qqqqLH/STM32_smart_door/BSP/BEEP/蜂鸣器.jpg

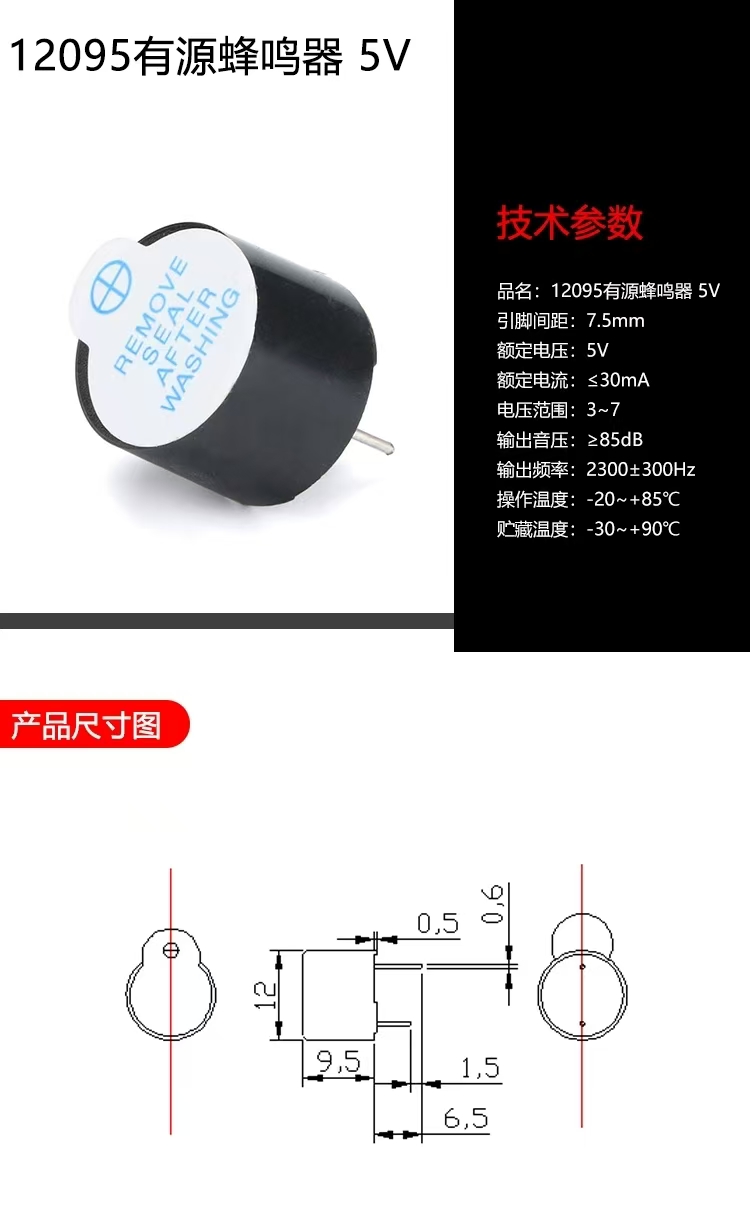
BSP/BEEP/蜂鸣器.jpg
