qqqqLH/STM32_smart_door/(list of files, cad)

Other CAD files:
BSP/SERVO/舵机控制例程/舵机控制例程/舵机例程/180度舵机 51单片机例程/STARTUP.OBJ
BSP/SERVO/舵机控制例程/舵机控制例程/舵机例程/360度舵机 51单片机例程/STARTUP.OBJ
BSP/SERVO/舵机控制例程/舵机控制例程/舵机例程/180度舵机 51单片机例程/180度舵机.OBJ
BSP/SERVO/舵机控制例程/舵机控制例程/舵机例程/360度舵机 51单片机例程/360度舵机.OBJ
