qqqqLH/STM32_smart_door/BSP/SERVO/舵机控制例程/舵机控制例程/舵机例程/180度舵机 STM32   例程/STM32_Server_180Test/OBJ/STM32_Server_Test.htm

# Static Call Graph for image ..\OBJ\STM32_Server_Test.axf

#<CALLGRAPH># ARM Linker, 5050106: Last Updated: Thu Oct 27 08:49:28 2022

### Maximum Stack Usage = 64 bytes + Unknown(Functions without stacksize, Cycles, Untraceable Function Pointers)

### Call chain for Maximum Stack Depth:

__rt_entry_main ⇒ main ⇒ TIM8_PWM_Init ⇒ GPIO_Init

### Functions with no stack information

- __user_initial_stackheap

### Mutually Recursive functions

- ADC1_2_IRQHandler ⇒ ADC1_2_IRQHandler

### Function Pointers

- ADC1_2_IRQHandler from startup_stm32f10x_hd.o(.text) referenced from startup_stm32f10x_hd.o(RESET)
- ADC3_IRQHandler from startup_stm32f10x_hd.o(.text) referenced from startup_stm32f10x_hd.o(RESET)
- BusFault_Handler from stm32f10x_it.o(.text) referenced from startup_stm32f10x_hd.o(RESET)
- CAN1_RX1_IRQHandler from startup_stm32f10x_hd.o(.text) referenced from startup_stm32f10x_hd.o(RESET)
- CAN1_SCE_IRQHandler from startup_stm32f10x_hd.o(.text) referenced from startup_stm32f10x_hd.o(RESET)
- DMA1_Channel1_IRQHandler from startup_stm32f10x_hd.o(.text) referenced from startup_stm32f10x_hd.o(RESET)
- DMA1_Channel2_IRQHandler from startup_stm32f10x_hd.o(.text) referenced from startup_stm32f10x_hd.o(RESET)
- DMA1_Channel3_IRQHandler from startup_stm32f10x_hd.o(.text) referenced from startup_stm32f10x_hd.o(RESET)
- DMA1_Channel4_IRQHandler from startup_stm32f10x_hd.o(.text) referenced from startup_stm32f10x_hd.o(RESET)
- DMA1_Channel5_IRQHandler from startup_stm32f10x_hd.o(.text) referenced from startup_stm32f10x_hd.o(RESET)
- DMA1_Channel6_IRQHandler from startup_stm32f10x_hd.o(.text) referenced from startup_stm32f10x_hd.o(RESET)
- DMA1_Channel7_IRQHandler from startup_stm32f10x_hd.o(.text) referenced from startup_stm32f10x_hd.o(RESET)
- DMA2_Channel1_IRQHandler from startup_stm32f10x_hd.o(.text) referenced from startup_stm32f10x_hd.o(RESET)
- DMA2_Channel2_IRQHandler from startup_stm32f10x_hd.o(.text) referenced from startup_stm32f10x_hd.o(RESET)
- DMA2_Channel3_IRQHandler from startup_stm32f10x_hd.o(.text) referenced from startup_stm32f10x_hd.o(RESET)
- DMA2_Channel4_5_IRQHandler from startup_stm32f10x_hd.o(.text) referenced from startup_stm32f10x_hd.o(RESET)
- DebugMon_Handler from stm32f10x_it.o(.text) referenced from startup_stm32f10x_hd.o(RESET)
- EXTI0_IRQHandler from startup_stm32f10x_hd.o(.text) referenced from startup_stm32f10x_hd.o(RESET)
- EXTI15_10_IRQHandler from startup_stm32f10x_hd.o(.text) referenced from startup_stm32f10x_hd.o(RESET)
- EXTI1_IRQHandler from startup_stm32f10x_hd.o(.text) referenced from startup_stm32f10x_hd.o(RESET)
- EXTI2_IRQHandler from startup_stm32f10x_hd.o(.text) referenced from startup_stm32f10x_hd.o(RESET)
- EXTI3_IRQHandler from startup_stm32f10x_hd.o(.text) referenced from startup_stm32f10x_hd.o(RESET)
- EXTI4_IRQHandler from startup_stm32f10x_hd.o(.text) referenced from startup_stm32f10x_hd.o(RESET)
- EXTI9_5_IRQHandler from startup_stm32f10x_hd.o(.text) referenced from startup_stm32f10x_hd.o(RESET)
- FLASH_IRQHandler from startup_stm32f10x_hd.o(.text) referenced from startup_stm32f10x_hd.o(RESET)
- FSMC_IRQHandler from startup_stm32f10x_hd.o(.text) referenced from startup_stm32f10x_hd.o(RESET)
- HardFault_Handler from stm32f10x_it.o(.text) referenced from startup_stm32f10x_hd.o(RESET)
- I2C1_ER_IRQHandler from startup_stm32f10x_hd.o(.text) referenced from startup_stm32f10x_hd.o(RESET)
- I2C1_EV_IRQHandler from startup_stm32f10x_hd.o(.text) referenced from startup_stm32f10x_hd.o(RESET)
- I2C2_ER_IRQHandler from startup_stm32f10x_hd.o(.text) referenced from startup_stm32f10x_hd.o(RESET)
- I2C2_EV_IRQHandler from startup_stm32f10x_hd.o(.text) referenced from startup_stm32f10x_hd.o(RESET)
- MemManage_Handler from stm32f10x_it.o(.text) referenced from startup_stm32f10x_hd.o(RESET)
- NMI_Handler from stm32f10x_it.o(.text) referenced from startup_stm32f10x_hd.o(RESET)
- PVD_IRQHandler from startup_stm32f10x_hd.o(.text) referenced from startup_stm32f10x_hd.o(RESET)
- PendSV_Handler from stm32f10x_it.o(.text) referenced from startup_stm32f10x_hd.o(RESET)
- RCC_IRQHandler from startup_stm32f10x_hd.o(.text) referenced from startup_stm32f10x_hd.o(RESET)
- RTCAlarm_IRQHandler from startup_stm32f10x_hd.o(.text) referenced from startup_stm32f10x_hd.o(RESET)
- RTC_IRQHandler from startup_stm32f10x_hd.o(.text) referenced from startup_stm32f10x_hd.o(RESET)
- Reset_Handler from startup_stm32f10x_hd.o(.text) referenced from startup_stm32f10x_hd.o(RESET)
- SDIO_IRQHandler from startup_stm32f10x_hd.o(.text) referenced from startup_stm32f10x_hd.o(RESET)
- SPI1_IRQHandler from startup_stm32f10x_hd.o(.text) referenced from startup_stm32f10x_hd.o(RESET)
- SPI2_IRQHandler from startup_stm32f10x_hd.o(.text) referenced from startup_stm32f10x_hd.o(RESET)
- SPI3_IRQHandler from startup_stm32f10x_hd.o(.text) referenced from startup_stm32f10x_hd.o(RESET)
- SVC_Handler from stm32f10x_it.o(.text) referenced from startup_stm32f10x_hd.o(RESET)
- SysTick_Handler from stm32f10x_it.o(.text) referenced from startup_stm32f10x_hd.o(RESET)
- SystemInit from system_stm32f10x.o(.text) referenced from startup_stm32f10x_hd.o(.text)
- TAMPER_IRQHandler from startup_stm32f10x_hd.o(.text) referenced from startup_stm32f10x_hd.o(RESET)
- TIM1_BRK_IRQHandler from startup_stm32f10x_hd.o(.text) referenced from startup_stm32f10x_hd.o(RESET)
- TIM1_CC_IRQHandler from startup_stm32f10x_hd.o(.text) referenced from startup_stm32f10x_hd.o(RESET)
- TIM1_TRG_COM_IRQHandler from startup_stm32f10x_hd.o(.text) referenced from startup_stm32f10x_hd.o(RESET)
- TIM1_UP_IRQHandler from startup_stm32f10x_hd.o(.text) referenced from startup_stm32f10x_hd.o(RESET)
- TIM2_IRQHandler from startup_stm32f10x_hd.o(.text) referenced from startup_stm32f10x_hd.o(RESET)
- TIM3_IRQHandler from startup_stm32f10x_hd.o(.text) referenced from startup_stm32f10x_hd.o(RESET)
- TIM4_IRQHandler from startup_stm32f10x_hd.o(.text) referenced from startup_stm32f10x_hd.o(RESET)
- TIM5_IRQHandler from startup_stm32f10x_hd.o(.text) referenced from startup_stm32f10x_hd.o(RESET)
- TIM6_IRQHandler from startup_stm32f10x_hd.o(.text) referenced from startup_stm32f10x_hd.o(RESET)
- TIM7_IRQHandler from startup_stm32f10x_hd.o(.text) referenced from startup_stm32f10x_hd.o(RESET)
- TIM8_BRK_IRQHandler from startup_stm32f10x_hd.o(.text) referenced from startup_stm32f10x_hd.o(RESET)
- TIM8_CC_IRQHandler from startup_stm32f10x_hd.o(.text) referenced from startup_stm32f10x_hd.o(RESET)
- TIM8_TRG_COM_IRQHandler from startup_stm32f10x_hd.o(.text) referenced from startup_stm32f10x_hd.o(RESET)
- TIM8_UP_IRQHandler from startup_stm32f10x_hd.o(.text) referenced from startup_stm32f10x_hd.o(RESET)
- UART4_IRQHandler from startup_stm32f10x_hd.o(.text) referenced from startup_stm32f10x_hd.o(RESET)
- UART5_IRQHandler from startup_stm32f10x_hd.o(.text) referenced from startup_stm32f10x_hd.o(RESET)
- USART1_IRQHandler from usart.o(.text) referenced from startup_stm32f10x_hd.o(RESET)
- USART2_IRQHandler from startup_stm32f10x_hd.o(.text) referenced from startup_stm32f10x_hd.o(RESET)
- USART3_IRQHandler from startup_stm32f10x_hd.o(.text) referenced from startup_stm32f10x_hd.o(RESET)
- USBWakeUp_IRQHandler from startup_stm32f10x_hd.o(.text) referenced from startup_stm32f10x_hd.o(RESET)
- USB_HP_CAN1_TX_IRQHandler from startup_stm32f10x_hd.o(.text) referenced from startup_stm32f10x_hd.o(RESET)
- USB_LP_CAN1_RX0_IRQHandler from startup_stm32f10x_hd.o(.text) referenced from startup_stm32f10x_hd.o(RESET)
- UsageFault_Handler from stm32f10x_it.o(.text) referenced from startup_stm32f10x_hd.o(RESET)
- WWDG_IRQHandler from startup_stm32f10x_hd.o(.text) referenced from startup_stm32f10x_hd.o(RESET)
- __main from __main.o(!!!main) referenced from startup_stm32f10x_hd.o(.text)

### Global Symbols

__main (Thumb, 8 bytes, Stack size 0 bytes, __main.o(!!!main))

[Calls]

- >> __scatterload
- >> __rt_entry

__scatterload (Thumb, 0 bytes, Stack size unknown bytes, __scatter.o(!!!scatter))

[Called By]

- >> __main

__scatterload_rt2 (Thumb, 44 bytes, Stack size unknown bytes, __scatter.o(!!!scatter), UNUSED)

[Calls]

- >> __rt_entry

__scatterload_rt2_thumb_only (Thumb, 0 bytes, Stack size unknown bytes, __scatter.o(!!!scatter), UNUSED)

__scatterload_null (Thumb, 0 bytes, Stack size unknown bytes, __scatter.o(!!!scatter), UNUSED)

__scatterload_copy (Thumb, 26 bytes, Stack size unknown bytes, __scatter_copy.o(!!handler_copy), UNUSED)

[Calls]

- >> __scatterload_copy

[Called By]

- >> __scatterload_copy

__scatterload_zeroinit (Thumb, 28 bytes, Stack size unknown bytes, __scatter_zi.o(!!handler_zi), UNUSED)

__rt_lib_init (Thumb, 0 bytes, Stack size unknown bytes, libinit.o(.ARM.Collect$$libinit$$00000000))

[Called By]

- >> __rt_entry_li

__rt_lib_init_alloca_1 (Thumb, 0 bytes, Stack size unknown bytes, libinit2.o(.ARM.Collect$$libinit$$0000002E))

__rt_lib_init_argv_1 (Thumb, 0 bytes, Stack size unknown bytes, libinit2.o(.ARM.Collect$$libinit$$0000002C))

__rt_lib_init_atexit_1 (Thumb, 0 bytes, Stack size unknown bytes, libinit2.o(.ARM.Collect$$libinit$$0000001B))

__rt_lib_init_clock_1 (Thumb, 0 bytes, Stack size unknown bytes, libinit2.o(.ARM.Collect$$libinit$$00000021))

__rt_lib_init_cpp_1 (Thumb, 0 bytes, Stack size unknown bytes, libinit2.o(.ARM.Collect$$libinit$$00000032))

__rt_lib_init_exceptions_1 (Thumb, 0 bytes, Stack size unknown bytes, libinit2.o(.ARM.Collect$$libinit$$00000030))

__rt_lib_init_fp_1 (Thumb, 0 bytes, Stack size unknown bytes, libinit2.o(.ARM.Collect$$libinit$$00000002))

__rt_lib_init_fp_trap_1 (Thumb, 0 bytes, Stack size unknown bytes, libinit2.o(.ARM.Collect$$libinit$$0000001F))

__rt_lib_init_getenv_1 (Thumb, 0 bytes, Stack size unknown bytes, libinit2.o(.ARM.Collect$$libinit$$00000023))

__rt_lib_init_heap_1 (Thumb, 0 bytes, Stack size unknown bytes, libinit2.o(.ARM.Collect$$libinit$$0000000A))

__rt_lib_init_lc_collate_1 (Thumb, 0 bytes, Stack size unknown bytes, libinit2.o(.ARM.Collect$$libinit$$00000011))

__rt_lib_init_lc_ctype_1 (Thumb, 0 bytes, Stack size unknown bytes, libinit2.o(.ARM.Collect$$libinit$$00000013))

__rt_lib_init_lc_monetary_1 (Thumb, 0 bytes, Stack size unknown bytes, libinit2.o(.ARM.Collect$$libinit$$00000015))

__rt_lib_init_lc_numeric_1 (Thumb, 0 bytes, Stack size unknown bytes, libinit2.o(.ARM.Collect$$libinit$$00000017))

__rt_lib_init_lc_time_1 (Thumb, 0 bytes, Stack size unknown bytes, libinit2.o(.ARM.Collect$$libinit$$00000019))

__rt_lib_init_preinit_1 (Thumb, 0 bytes, Stack size unknown bytes, libinit2.o(.ARM.Collect$$libinit$$00000004))

__rt_lib_init_rand_1 (Thumb, 0 bytes, Stack size unknown bytes, libinit2.o(.ARM.Collect$$libinit$$0000000E))

__rt_lib_init_return (Thumb, 0 bytes, Stack size unknown bytes, libinit2.o(.ARM.Collect$$libinit$$00000033))

__rt_lib_init_signal_1 (Thumb, 0 bytes, Stack size unknown bytes, libinit2.o(.ARM.Collect$$libinit$$0000001D))

__rt_lib_init_stdio_1 (Thumb, 0 bytes, Stack size unknown bytes, libinit2.o(.ARM.Collect$$libinit$$00000025))

__rt_lib_init_user_alloc_1 (Thumb, 0 bytes, Stack size unknown bytes, libinit2.o(.ARM.Collect$$libinit$$0000000C))

__rt_lib_shutdown (Thumb, 0 bytes, Stack size unknown bytes, libshutdown.o(.ARM.Collect$$libshutdown$$00000000))

[Called By]

- >> __rt_exit_ls

__rt_lib_shutdown_fp_trap_1 (Thumb, 0 bytes, Stack size unknown bytes, libshutdown2.o(.ARM.Collect$$libshutdown$$00000006))

__rt_lib_shutdown_heap_1 (Thumb, 0 bytes, Stack size unknown bytes, libshutdown2.o(.ARM.Collect$$libshutdown$$0000000E))

__rt_lib_shutdown_return (Thumb, 0 bytes, Stack size unknown bytes, libshutdown2.o(.ARM.Collect$$libshutdown$$0000000F))

__rt_lib_shutdown_signal_1 (Thumb, 0 bytes, Stack size unknown bytes, libshutdown2.o(.ARM.Collect$$libshutdown$$00000009))

__rt_lib_shutdown_stdio_1 (Thumb, 0 bytes, Stack size unknown bytes, libshutdown2.o(.ARM.Collect$$libshutdown$$00000003))

__rt_lib_shutdown_user_alloc_1 (Thumb, 0 bytes, Stack size unknown bytes, libshutdown2.o(.ARM.Collect$$libshutdown$$0000000B))

__rt_entry (Thumb, 0 bytes, Stack size unknown bytes, __rtentry.o(.ARM.Collect$$rtentry$$00000000))

[Called By]

- >> __scatterload_rt2
- >> __main

__rt_entry_presh_1 (Thumb, 0 bytes, Stack size unknown bytes, __rtentry2.o(.ARM.Collect$$rtentry$$00000002))

__rt_entry_sh (Thumb, 0 bytes, Stack size unknown bytes, __rtentry4.o(.ARM.Collect$$rtentry$$00000004))

[Stack]

- Max Depth = 8 + Unknown Stack Size
- Call Chain = __rt_entry_sh ⇒ __user_setup_stackheap

[Calls]

- >> __user_setup_stackheap

__rt_entry_li (Thumb, 0 bytes, Stack size unknown bytes, __rtentry2.o(.ARM.Collect$$rtentry$$0000000A))

[Calls]

- >> __rt_lib_init

__rt_entry_postsh_1 (Thumb, 0 bytes, Stack size unknown bytes, __rtentry2.o(.ARM.Collect$$rtentry$$00000009))

__rt_entry_main (Thumb, 0 bytes, Stack size unknown bytes, __rtentry2.o(.ARM.Collect$$rtentry$$0000000D))

[Stack]

- Max Depth = 64 + Unknown Stack Size
- Call Chain = __rt_entry_main ⇒ main ⇒ TIM8_PWM_Init ⇒ GPIO_Init

[Calls]

- >> main
- >> exit

__rt_entry_postli_1 (Thumb, 0 bytes, Stack size unknown bytes, __rtentry2.o(.ARM.Collect$$rtentry$$0000000C))

__rt_exit (Thumb, 0 bytes, Stack size unknown bytes, rtexit.o(.ARM.Collect$$rtexit$$00000000))

[Called By]

- >> exit

__rt_exit_ls (Thumb, 0 bytes, Stack size unknown bytes, rtexit2.o(.ARM.Collect$$rtexit$$00000003))

[Calls]

- >> __rt_lib_shutdown

__rt_exit_prels_1 (Thumb, 0 bytes, Stack size unknown bytes, rtexit2.o(.ARM.Collect$$rtexit$$00000002))

__rt_exit_exit (Thumb, 0 bytes, Stack size unknown bytes, rtexit2.o(.ARM.Collect$$rtexit$$00000004))

[Calls]

- >> _sys_exit

Server_360_Forward (Thumb, 52 bytes, Stack size 8 bytes, main.o(.text), UNUSED)

[Calls]

- >> delay_ms
- >> TIM_SetCompare1

Server_180_Angle (Thumb, 52 bytes, Stack size 8 bytes, main.o(.text))

[Stack]

- Max Depth = 8
- Call Chain = Server_180_Angle

[Calls]

- >> delay_ms
- >> TIM_SetCompare1

[Called By]

- >> main

main (Thumb, 16 bytes, Stack size 0 bytes, main.o(.text))

[Stack]

- Max Depth = 64
- Call Chain = main ⇒ TIM8_PWM_Init ⇒ GPIO_Init

[Calls]

- >> delay_init
- >> TIM8_PWM_Init
- >> Server_180_Angle

[Called By]

- >> __rt_entry_main

NMI_Handler (Thumb, 2 bytes, Stack size 0 bytes, stm32f10x_it.o(.text))
[Address Reference Count : 1]

- startup_stm32f10x_hd.o(RESET)

HardFault_Handler (Thumb, 4 bytes, Stack size 0 bytes, stm32f10x_it.o(.text))
[Address Reference Count : 1]

- startup_stm32f10x_hd.o(RESET)

MemManage_Handler (Thumb, 4 bytes, Stack size 0 bytes, stm32f10x_it.o(.text))
[Address Reference Count : 1]

- startup_stm32f10x_hd.o(RESET)

BusFault_Handler (Thumb, 4 bytes, Stack size 0 bytes, stm32f10x_it.o(.text))
[Address Reference Count : 1]

- startup_stm32f10x_hd.o(RESET)

UsageFault_Handler (Thumb, 4 bytes, Stack size 0 bytes, stm32f10x_it.o(.text))
[Address Reference Count : 1]

- startup_stm32f10x_hd.o(RESET)

SVC_Handler (Thumb, 2 bytes, Stack size 0 bytes, stm32f10x_it.o(.text))
[Address Reference Count : 1]

- startup_stm32f10x_hd.o(RESET)

DebugMon_Handler (Thumb, 2 bytes, Stack size 0 bytes, stm32f10x_it.o(.text))
[Address Reference Count : 1]

- startup_stm32f10x_hd.o(RESET)

PendSV_Handler (Thumb, 2 bytes, Stack size 0 bytes, stm32f10x_it.o(.text))
[Address Reference Count : 1]

- startup_stm32f10x_hd.o(RESET)

SysTick_Handler (Thumb, 2 bytes, Stack size 0 bytes, stm32f10x_it.o(.text))
[Address Reference Count : 1]

- startup_stm32f10x_hd.o(RESET)

SystemInit (Thumb, 78 bytes, Stack size 8 bytes, system_stm32f10x.o(.text))

[Stack]

- Max Depth = 28
- Call Chain = SystemInit ⇒ SetSysClock ⇒ SetSysClockTo72

[Calls]

- >> SetSysClock

[Address Reference Count : 1]

- startup_stm32f10x_hd.o(.text)

SystemCoreClockUpdate (Thumb, 142 bytes, Stack size 8 bytes, system_stm32f10x.o(.text), UNUSED)

Reset_Handler (Thumb, 8 bytes, Stack size 0 bytes, startup_stm32f10x_hd.o(.text))
[Address Reference Count : 1]

- startup_stm32f10x_hd.o(RESET)

ADC1_2_IRQHandler (Thumb, 0 bytes, Stack size 0 bytes, startup_stm32f10x_hd.o(.text))

[Calls]

- >> ADC1_2_IRQHandler

[Called By]

- >> ADC1_2_IRQHandler

[Address Reference Count : 1]

- startup_stm32f10x_hd.o(RESET)

ADC3_IRQHandler (Thumb, 0 bytes, Stack size 0 bytes, startup_stm32f10x_hd.o(.text))
[Address Reference Count : 1]

- startup_stm32f10x_hd.o(RESET)

CAN1_RX1_IRQHandler (Thumb, 0 bytes, Stack size 0 bytes, startup_stm32f10x_hd.o(.text))
[Address Reference Count : 1]

- startup_stm32f10x_hd.o(RESET)

CAN1_SCE_IRQHandler (Thumb, 0 bytes, Stack size 0 bytes, startup_stm32f10x_hd.o(.text))
[Address Reference Count : 1]

- startup_stm32f10x_hd.o(RESET)

DMA1_Channel1_IRQHandler (Thumb, 0 bytes, Stack size 0 bytes, startup_stm32f10x_hd.o(.text))
[Address Reference Count : 1]

- startup_stm32f10x_hd.o(RESET)

DMA1_Channel2_IRQHandler (Thumb, 0 bytes, Stack size 0 bytes, startup_stm32f10x_hd.o(.text))
[Address Reference Count : 1]

- startup_stm32f10x_hd.o(RESET)

DMA1_Channel3_IRQHandler (Thumb, 0 bytes, Stack size 0 bytes, startup_stm32f10x_hd.o(.text))
[Address Reference Count : 1]

- startup_stm32f10x_hd.o(RESET)

DMA1_Channel4_IRQHandler (Thumb, 0 bytes, Stack size 0 bytes, startup_stm32f10x_hd.o(.text))
[Address Reference Count : 1]

- startup_stm32f10x_hd.o(RESET)

DMA1_Channel5_IRQHandler (Thumb, 0 bytes, Stack size 0 bytes, startup_stm32f10x_hd.o(.text))
[Address Reference Count : 1]

- startup_stm32f10x_hd.o(RESET)

DMA1_Channel6_IRQHandler (Thumb, 0 bytes, Stack size 0 bytes, startup_stm32f10x_hd.o(.text))
[Address Reference Count : 1]

- startup_stm32f10x_hd.o(RESET)

DMA1_Channel7_IRQHandler (Thumb, 0 bytes, Stack size 0 bytes, startup_stm32f10x_hd.o(.text))
[Address Reference Count : 1]

- startup_stm32f10x_hd.o(RESET)

DMA2_Channel1_IRQHandler (Thumb, 0 bytes, Stack size 0 bytes, startup_stm32f10x_hd.o(.text))
[Address Reference Count : 1]

- startup_stm32f10x_hd.o(RESET)

DMA2_Channel2_IRQHandler (Thumb, 0 bytes, Stack size 0 bytes, startup_stm32f10x_hd.o(.text))
[Address Reference Count : 1]

- startup_stm32f10x_hd.o(RESET)

DMA2_Channel3_IRQHandler (Thumb, 0 bytes, Stack size 0 bytes, startup_stm32f10x_hd.o(.text))
[Address Reference Count : 1]

- startup_stm32f10x_hd.o(RESET)

DMA2_Channel4_5_IRQHandler (Thumb, 0 bytes, Stack size 0 bytes, startup_stm32f10x_hd.o(.text))
[Address Reference Count : 1]

- startup_stm32f10x_hd.o(RESET)

EXTI0_IRQHandler (Thumb, 0 bytes, Stack size 0 bytes, startup_stm32f10x_hd.o(.text))
[Address Reference Count : 1]

- startup_stm32f10x_hd.o(RESET)

EXTI15_10_IRQHandler (Thumb, 0 bytes, Stack size 0 bytes, startup_stm32f10x_hd.o(.text))
[Address Reference Count : 1]

- startup_stm32f10x_hd.o(RESET)

EXTI1_IRQHandler (Thumb, 0 bytes, Stack size 0 bytes, startup_stm32f10x_hd.o(.text))
[Address Reference Count : 1]

- startup_stm32f10x_hd.o(RESET)

EXTI2_IRQHandler (Thumb, 0 bytes, Stack size 0 bytes, startup_stm32f10x_hd.o(.text))
[Address Reference Count : 1]

- startup_stm32f10x_hd.o(RESET)

EXTI3_IRQHandler (Thumb, 0 bytes, Stack size 0 bytes, startup_stm32f10x_hd.o(.text))
[Address Reference Count : 1]

- startup_stm32f10x_hd.o(RESET)

EXTI4_IRQHandler (Thumb, 0 bytes, Stack size 0 bytes, startup_stm32f10x_hd.o(.text))
[Address Reference Count : 1]

- startup_stm32f10x_hd.o(RESET)

EXTI9_5_IRQHandler (Thumb, 0 bytes, Stack size 0 bytes, startup_stm32f10x_hd.o(.text))
[Address Reference Count : 1]

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

TIM8_UP_IRQHandler (Thumb, 0 bytes, Stack size 0 bytes, startup_stm32f10x_hd.o(.text))
[Address Reference Count : 1]

- startup_stm32f10x_hd.o(RESET)

UART4_IRQHandler (Thumb, 0 bytes, Stack size 0 bytes, startup_stm32f10x_hd.o(.text))
[Address Reference Count : 1]

- startup_stm32f10x_hd.o(RESET)

UART5_IRQHandler (Thumb, 0 bytes, Stack size 0 bytes, startup_stm32f10x_hd.o(.text))
[Address Reference Count : 1]

- startup_stm32f10x_hd.o(RESET)

USART2_IRQHandler (Thumb, 0 bytes, Stack size 0 bytes, startup_stm32f10x_hd.o(.text))
[Address Reference Count : 1]

- startup_stm32f10x_hd.o(RESET)

USART3_IRQHandler (Thumb, 0 bytes, Stack size 0 bytes, startup_stm32f10x_hd.o(.text))
[Address Reference Count : 1]

- startup_stm32f10x_hd.o(RESET)

USBWakeUp_IRQHandler (Thumb, 0 bytes, Stack size 0 bytes, startup_stm32f10x_hd.o(.text))
[Address Reference Count : 1]

- startup_stm32f10x_hd.o(RESET)

USB_HP_CAN1_TX_IRQHandler (Thumb, 0 bytes, Stack size 0 bytes, startup_stm32f10x_hd.o(.text))
[Address Reference Count : 1]

- startup_stm32f10x_hd.o(RESET)

USB_LP_CAN1_RX0_IRQHandler (Thumb, 0 bytes, Stack size 0 bytes, startup_stm32f10x_hd.o(.text))
[Address Reference Count : 1]

- startup_stm32f10x_hd.o(RESET)

WWDG_IRQHandler (Thumb, 0 bytes, Stack size 0 bytes, startup_stm32f10x_hd.o(.text))
[Address Reference Count : 1]

- startup_stm32f10x_hd.o(RESET)

__user_initial_stackheap (Thumb, 0 bytes, Stack size unknown bytes, startup_stm32f10x_hd.o(.text))

[Called By]

- >> __user_setup_stackheap

NVIC_PriorityGroupConfig (Thumb, 10 bytes, Stack size 0 bytes, misc.o(.text), UNUSED)

NVIC_Init (Thumb, 100 bytes, Stack size 16 bytes, misc.o(.text), UNUSED)

[Called By]

- >> uart_init

NVIC_SetVectorTable (Thumb, 14 bytes, Stack size 0 bytes, misc.o(.text), UNUSED)

NVIC_SystemLPConfig (Thumb, 34 bytes, Stack size 0 bytes, misc.o(.text), UNUSED)

SysTick_CLKSourceConfig (Thumb, 40 bytes, Stack size 0 bytes, misc.o(.text))

[Called By]

- >> delay_init

GPIO_DeInit (Thumb, 172 bytes, Stack size 8 bytes, stm32f10x_gpio.o(.text), UNUSED)

[Calls]

- >> RCC_APB2PeriphResetCmd

GPIO_AFIODeInit (Thumb, 20 bytes, Stack size 8 bytes, stm32f10x_gpio.o(.text), UNUSED)

[Calls]

- >> RCC_APB2PeriphResetCmd

GPIO_Init (Thumb, 278 bytes, Stack size 24 bytes, stm32f10x_gpio.o(.text))

[Stack]

- Max Depth = 24
- Call Chain = GPIO_Init

[Called By]

- >> TIM8_PWM_Init
- >> uart_init

GPIO_StructInit (Thumb, 16 bytes, Stack size 0 bytes, stm32f10x_gpio.o(.text), UNUSED)

GPIO_ReadInputDataBit (Thumb, 18 bytes, Stack size 0 bytes, stm32f10x_gpio.o(.text), UNUSED)

GPIO_ReadInputData (Thumb, 8 bytes, Stack size 0 bytes, stm32f10x_gpio.o(.text), UNUSED)

GPIO_ReadOutputDataBit (Thumb, 18 bytes, Stack size 0 bytes, stm32f10x_gpio.o(.text), UNUSED)

GPIO_ReadOutputData (Thumb, 8 bytes, Stack size 0 bytes, stm32f10x_gpio.o(.text), UNUSED)

GPIO_SetBits (Thumb, 4 bytes, Stack size 0 bytes, stm32f10x_gpio.o(.text), UNUSED)

GPIO_ResetBits (Thumb, 4 bytes, Stack size 0 bytes, stm32f10x_gpio.o(.text), UNUSED)

GPIO_WriteBit (Thumb, 10 bytes, Stack size 0 bytes, stm32f10x_gpio.o(.text), UNUSED)

GPIO_Write (Thumb, 4 bytes, Stack size 0 bytes, stm32f10x_gpio.o(.text), UNUSED)

GPIO_PinLockConfig (Thumb, 18 bytes, Stack size 0 bytes, stm32f10x_gpio.o(.text), UNUSED)

GPIO_EventOutputConfig (Thumb, 26 bytes, Stack size 0 bytes, stm32f10x_gpio.o(.text), UNUSED)

GPIO_EventOutputCmd (Thumb, 6 bytes, Stack size 0 bytes, stm32f10x_gpio.o(.text), UNUSED)

GPIO_PinRemapConfig (Thumb, 138 bytes, Stack size 20 bytes, stm32f10x_gpio.o(.text), UNUSED)

GPIO_EXTILineConfig (Thumb, 66 bytes, Stack size 12 bytes, stm32f10x_gpio.o(.text), UNUSED)

GPIO_ETH_MediaInterfaceConfig (Thumb, 8 bytes, Stack size 0 bytes, stm32f10x_gpio.o(.text), UNUSED)

RCC_DeInit (Thumb, 64 bytes, Stack size 0 bytes, stm32f10x_rcc.o(.text), UNUSED)

RCC_HSEConfig (Thumb, 70 bytes, Stack size 0 bytes, stm32f10x_rcc.o(.text), UNUSED)

RCC_GetFlagStatus (Thumb, 56 bytes, Stack size 8 bytes, stm32f10x_rcc.o(.text), UNUSED)

[Called By]

- >> RCC_WaitForHSEStartUp

RCC_WaitForHSEStartUp (Thumb, 56 bytes, Stack size 16 bytes, stm32f10x_rcc.o(.text), UNUSED)

[Calls]

- >> RCC_GetFlagStatus

RCC_AdjustHSICalibrationValue (Thumb, 20 bytes, Stack size 0 bytes, stm32f10x_rcc.o(.text), UNUSED)

RCC_HSICmd (Thumb, 6 bytes, Stack size 0 bytes, stm32f10x_rcc.o(.text), UNUSED)

RCC_PLLConfig (Thumb, 24 bytes, Stack size 0 bytes, stm32f10x_rcc.o(.text), UNUSED)

RCC_PLLCmd (Thumb, 6 bytes, Stack size 0 bytes, stm32f10x_rcc.o(.text), UNUSED)

RCC_SYSCLKConfig (Thumb, 18 bytes, Stack size 0 bytes, stm32f10x_rcc.o(.text), UNUSED)

RCC_GetSYSCLKSource (Thumb, 10 bytes, Stack size 0 bytes, stm32f10x_rcc.o(.text), UNUSED)

RCC_HCLKConfig (Thumb, 18 bytes, Stack size 0 bytes, stm32f10x_rcc.o(.text), UNUSED)

RCC_PCLK1Config (Thumb, 18 bytes, Stack size 0 bytes, stm32f10x_rcc.o(.text), UNUSED)

RCC_PCLK2Config (Thumb, 20 bytes, Stack size 0 bytes, stm32f10x_rcc.o(.text), UNUSED)

RCC_ITConfig (Thumb, 26 bytes, Stack size 0 bytes, stm32f10x_rcc.o(.text), UNUSED)

RCC_USBCLKConfig (Thumb, 8 bytes, Stack size 0 bytes, stm32f10x_rcc.o(.text), UNUSED)

RCC_ADCCLKConfig (Thumb, 18 bytes, Stack size 0 bytes, stm32f10x_rcc.o(.text), UNUSED)

RCC_LSEConfig (Thumb, 50 bytes, Stack size 0 bytes, stm32f10x_rcc.o(.text), UNUSED)

RCC_LSICmd (Thumb, 6 bytes, Stack size 0 bytes, stm32f10x_rcc.o(.text), UNUSED)

RCC_RTCCLKConfig (Thumb, 12 bytes, Stack size 0 bytes, stm32f10x_rcc.o(.text), UNUSED)

RCC_RTCCLKCmd (Thumb, 8 bytes, Stack size 0 bytes, stm32f10x_rcc.o(.text), UNUSED)

RCC_GetClocksFreq (Thumb, 192 bytes, Stack size 12 bytes, stm32f10x_rcc.o(.text), UNUSED)

[Called By]

- >> USART_Init

RCC_AHBPeriphClockCmd (Thumb, 26 bytes, Stack size 0 bytes, stm32f10x_rcc.o(.text), UNUSED)

RCC_APB2PeriphClockCmd (Thumb, 26 bytes, Stack size 0 bytes, stm32f10x_rcc.o(.text))

[Called By]

- >> TIM8_PWM_Init
- >> uart_init

RCC_APB1PeriphClockCmd (Thumb, 26 bytes, Stack size 0 bytes, stm32f10x_rcc.o(.text), UNUSED)

RCC_APB2PeriphResetCmd (Thumb, 26 bytes, Stack size 0 bytes, stm32f10x_rcc.o(.text), UNUSED)

[Called By]

- >> TIM_DeInit
- >> GPIO_AFIODeInit
- >> GPIO_DeInit
- >> USART_DeInit

RCC_APB1PeriphResetCmd (Thumb, 26 bytes, Stack size 0 bytes, stm32f10x_rcc.o(.text), UNUSED)

[Called By]

- >> TIM_DeInit
- >> USART_DeInit

RCC_BackupResetCmd (Thumb, 8 bytes, Stack size 0 bytes, stm32f10x_rcc.o(.text), UNUSED)

RCC_ClockSecuritySystemCmd (Thumb, 6 bytes, Stack size 0 bytes, stm32f10x_rcc.o(.text), UNUSED)

RCC_MCOConfig (Thumb, 6 bytes, Stack size 0 bytes, stm32f10x_rcc.o(.text), UNUSED)

RCC_ClearFlag (Thumb, 14 bytes, Stack size 0 bytes, stm32f10x_rcc.o(.text), UNUSED)

RCC_GetITStatus (Thumb, 20 bytes, Stack size 0 bytes, stm32f10x_rcc.o(.text), UNUSED)

RCC_ClearITPendingBit (Thumb, 6 bytes, Stack size 0 bytes, stm32f10x_rcc.o(.text), UNUSED)

TIM_DeInit (Thumb, 424 bytes, Stack size 8 bytes, stm32f10x_tim.o(.text), UNUSED)

[Calls]

- >> RCC_APB1PeriphResetCmd
- >> RCC_APB2PeriphResetCmd

TIM_TimeBaseInit (Thumb, 122 bytes, Stack size 0 bytes, stm32f10x_tim.o(.text))

[Called By]

- >> TIM8_PWM_Init

TIM_OC1Init (Thumb, 132 bytes, Stack size 16 bytes, stm32f10x_tim.o(.text))

[Stack]

- Max Depth = 16
- Call Chain = TIM_OC1Init

[Called By]

- >> TIM8_PWM_Init

TIM_OC2Init (Thumb, 154 bytes, Stack size 16 bytes, stm32f10x_tim.o(.text), UNUSED)

TIM_OC3Init (Thumb, 150 bytes, Stack size 16 bytes, stm32f10x_tim.o(.text), UNUSED)

TIM_OC4Init (Thumb, 182 bytes, Stack size 16 bytes, stm32f10x_tim.o(.text), UNUSED)

TIM_SetIC4Prescaler (Thumb, 26 bytes, Stack size 0 bytes, stm32f10x_tim.o(.text), UNUSED)

[Called By]

- >> TIM_ICInit

TIM_SetIC3Prescaler (Thumb, 18 bytes, Stack size 0 bytes, stm32f10x_tim.o(.text), UNUSED)

[Called By]

- >> TIM_ICInit

TIM_SetIC2Prescaler (Thumb, 26 bytes, Stack size 0 bytes, stm32f10x_tim.o(.text), UNUSED)

[Called By]

- >> TIM_PWMIConfig
- >> TIM_ICInit

TIM_SetIC1Prescaler (Thumb, 18 bytes, Stack size 0 bytes, stm32f10x_tim.o(.text), UNUSED)

[Called By]

- >> TIM_PWMIConfig
- >> TIM_ICInit

TIM_ICInit (Thumb, 150 bytes, Stack size 16 bytes, stm32f10x_tim.o(.text), UNUSED)

[Calls]

- >> TIM_SetIC2Prescaler
- >> TIM_SetIC3Prescaler
- >> TIM_SetIC4Prescaler
- >> TI1_Config
- >> TI2_Config
- >> TI3_Config
- >> TI4_Config
- >> TIM_SetIC1Prescaler

TIM_PWMIConfig (Thumb, 124 bytes, Stack size 24 bytes, stm32f10x_tim.o(.text), UNUSED)

[Calls]

- >> TIM_SetIC2Prescaler
- >> TI1_Config
- >> TI2_Config
- >> TIM_SetIC1Prescaler

TIM_BDTRConfig (Thumb, 32 bytes, Stack size 0 bytes, stm32f10x_tim.o(.text), UNUSED)

TIM_TimeBaseStructInit (Thumb, 18 bytes, Stack size 0 bytes, stm32f10x_tim.o(.text), UNUSED)

TIM_OCStructInit (Thumb, 20 bytes, Stack size 0 bytes, stm32f10x_tim.o(.text), UNUSED)

TIM_ICStructInit (Thumb, 18 bytes, Stack size 0 bytes, stm32f10x_tim.o(.text), UNUSED)

TIM_BDTRStructInit (Thumb, 40 bytes, Stack size 0 bytes, stm32f10x_tim.o(.text), UNUSED)

TIM_Cmd (Thumb, 24 bytes, Stack size 0 bytes, stm32f10x_tim.o(.text))

[Called By]

- >> TIM8_PWM_Init

TIM_CtrlPWMOutputs (Thumb, 30 bytes, Stack size 0 bytes, stm32f10x_tim.o(.text))

[Called By]

- >> TIM8_PWM_Init

TIM_ITConfig (Thumb, 18 bytes, Stack size 0 bytes, stm32f10x_tim.o(.text), UNUSED)

TIM_GenerateEvent (Thumb, 4 bytes, Stack size 0 bytes, stm32f10x_tim.o(.text), UNUSED)

TIM_DMAConfig (Thumb, 10 bytes, Stack size 0 bytes, stm32f10x_tim.o(.text), UNUSED)

TIM_DMACmd (Thumb, 18 bytes, Stack size 0 bytes, stm32f10x_tim.o(.text), UNUSED)

TIM_InternalClockConfig (Thumb, 12 bytes, Stack size 0 bytes, stm32f10x_tim.o(.text), UNUSED)

TIM_SelectInputTrigger (Thumb, 18 bytes, Stack size 0 bytes, stm32f10x_tim.o(.text), UNUSED)

[Called By]

- >> TIM_TIxExternalClockConfig
- >> TIM_ITRxExternalClockConfig

TIM_ITRxExternalClockConfig (Thumb, 24 bytes, Stack size 12 bytes, stm32f10x_tim.o(.text), UNUSED)

[Calls]

- >> TIM_SelectInputTrigger

TIM_TIxExternalClockConfig (Thumb, 62 bytes, Stack size 24 bytes, stm32f10x_tim.o(.text), UNUSED)

[Calls]

- >> TI1_Config
- >> TI2_Config
- >> TIM_SelectInputTrigger

TIM_ETRConfig (Thumb, 28 bytes, Stack size 12 bytes, stm32f10x_tim.o(.text), UNUSED)

[Called By]

- >> TIM_ETRClockMode2Config
- >> TIM_ETRClockMode1Config

TIM_ETRClockMode1Config (Thumb, 54 bytes, Stack size 24 bytes, stm32f10x_tim.o(.text), UNUSED)

[Calls]

- >> TIM_ETRConfig

TIM_ETRClockMode2Config (Thumb, 32 bytes, Stack size 20 bytes, stm32f10x_tim.o(.text), UNUSED)

[Calls]

- >> TIM_ETRConfig

TIM_PrescalerConfig (Thumb, 6 bytes, Stack size 0 bytes, stm32f10x_tim.o(.text), UNUSED)

TIM_CounterModeConfig (Thumb, 18 bytes, Stack size 0 bytes, stm32f10x_tim.o(.text), UNUSED)

TIM_EncoderInterfaceConfig (Thumb, 66 bytes, Stack size 20 bytes, stm32f10x_tim.o(.text), UNUSED)

TIM_ForcedOC1Config (Thumb, 18 bytes, Stack size 0 bytes, stm32f10x_tim.o(.text), UNUSED)

TIM_ForcedOC2Config (Thumb, 26 bytes, Stack size 0 bytes, stm32f10x_tim.o(.text), UNUSED)

TIM_ForcedOC3Config (Thumb, 18 bytes, Stack size 0 bytes, stm32f10x_tim.o(.text), UNUSED)

TIM_ForcedOC4Config (Thumb, 26 bytes, Stack size 0 bytes, stm32f10x_tim.o(.text), UNUSED)

TIM_ARRPreloadConfig (Thumb, 24 bytes, Stack size 0 bytes, stm32f10x_tim.o(.text), UNUSED)

TIM_SelectCOM (Thumb, 24 bytes, Stack size 0 bytes, stm32f10x_tim.o(.text), UNUSED)

TIM_SelectCCDMA (Thumb, 24 bytes, Stack size 0 bytes, stm32f10x_tim.o(.text), UNUSED)

TIM_CCPreloadControl (Thumb, 24 bytes, Stack size 0 bytes, stm32f10x_tim.o(.text), UNUSED)

TIM_OC1PreloadConfig (Thumb, 18 bytes, Stack size 0 bytes, stm32f10x_tim.o(.text))

[Called By]

- >> TIM8_PWM_Init

TIM_OC2PreloadConfig (Thumb, 26 bytes, Stack size 0 bytes, stm32f10x_tim.o(.text), UNUSED)

TIM_OC3PreloadConfig (Thumb, 18 bytes, Stack size 0 bytes, stm32f10x_tim.o(.text), UNUSED)

TIM_OC4PreloadConfig (Thumb, 26 bytes, Stack size 0 bytes, stm32f10x_tim.o(.text), UNUSED)

TIM_OC1FastConfig (Thumb, 18 bytes, Stack size 0 bytes, stm32f10x_tim.o(.text), UNUSED)

TIM_OC2FastConfig (Thumb, 26 bytes, Stack size 0 bytes, stm32f10x_tim.o(.text), UNUSED)

TIM_OC3FastConfig (Thumb, 18 bytes, Stack size 0 bytes, stm32f10x_tim.o(.text), UNUSED)

TIM_OC4FastConfig (Thumb, 26 bytes, Stack size 0 bytes, stm32f10x_tim.o(.text), UNUSED)

TIM_ClearOC1Ref (Thumb, 18 bytes, Stack size 0 bytes, stm32f10x_tim.o(.text), UNUSED)

TIM_ClearOC2Ref (Thumb, 24 bytes, Stack size 0 bytes, stm32f10x_tim.o(.text), UNUSED)

TIM_ClearOC3Ref (Thumb, 18 bytes, Stack size 0 bytes, stm32f10x_tim.o(.text), UNUSED)

TIM_ClearOC4Ref (Thumb, 24 bytes, Stack size 0 bytes, stm32f10x_tim.o(.text), UNUSED)

TIM_OC1PolarityConfig (Thumb, 18 bytes, Stack size 0 bytes, stm32f10x_tim.o(.text), UNUSED)

TIM_OC1NPolarityConfig (Thumb, 18 bytes, Stack size 0 bytes, stm32f10x_tim.o(.text), UNUSED)

TIM_OC2PolarityConfig (Thumb, 26 bytes, Stack size 0 bytes, stm32f10x_tim.o(.text), UNUSED)

TIM_OC2NPolarityConfig (Thumb, 26 bytes, Stack size 0 bytes, stm32f10x_tim.o(.text), UNUSED)

TIM_OC3PolarityConfig (Thumb, 26 bytes, Stack size 0 bytes, stm32f10x_tim.o(.text), UNUSED)

TIM_OC3NPolarityConfig (Thumb, 26 bytes, Stack size 0 bytes, stm32f10x_tim.o(.text), UNUSED)

TIM_OC4PolarityConfig (Thumb, 26 bytes, Stack size 0 bytes, stm32f10x_tim.o(.text), UNUSED)

TIM_CCxCmd (Thumb, 30 bytes, Stack size 12 bytes, stm32f10x_tim.o(.text), UNUSED)

TIM_CCxNCmd (Thumb, 30 bytes, Stack size 12 bytes, stm32f10x_tim.o(.text), UNUSED)

TIM_SelectOCxM (Thumb, 82 bytes, Stack size 16 bytes, stm32f10x_tim.o(.text), UNUSED)

TIM_UpdateDisableConfig (Thumb, 24 bytes, Stack size 0 bytes, stm32f10x_tim.o(.text), UNUSED)

TIM_UpdateRequestConfig (Thumb, 24 bytes, Stack size 0 bytes, stm32f10x_tim.o(.text), UNUSED)

TIM_SelectHallSensor (Thumb, 24 bytes, Stack size 0 bytes, stm32f10x_tim.o(.text), UNUSED)

TIM_SelectOnePulseMode (Thumb, 18 bytes, Stack size 0 bytes, stm32f10x_tim.o(.text), UNUSED)

TIM_SelectOutputTrigger (Thumb, 18 bytes, Stack size 0 bytes, stm32f10x_tim.o(.text), UNUSED)

TIM_SelectSlaveMode (Thumb, 18 bytes, Stack size 0 bytes, stm32f10x_tim.o(.text), UNUSED)

TIM_SelectMasterSlaveMode (Thumb, 18 bytes, Stack size 0 bytes, stm32f10x_tim.o(.text), UNUSED)

TIM_SetCounter (Thumb, 4 bytes, Stack size 0 bytes, stm32f10x_tim.o(.text), UNUSED)

TIM_SetAutoreload (Thumb, 4 bytes, Stack size 0 bytes, stm32f10x_tim.o(.text), UNUSED)

TIM_SetCompare1 (Thumb, 4 bytes, Stack size 0 bytes, stm32f10x_tim.o(.text))

[Called By]

- >> Server_180_Angle
- >> Server_360_Forward

TIM_SetCompare2 (Thumb, 4 bytes, Stack size 0 bytes, stm32f10x_tim.o(.text), UNUSED)

TIM_SetCompare3 (Thumb, 4 bytes, Stack size 0 bytes, stm32f10x_tim.o(.text), UNUSED)

TIM_SetCompare4 (Thumb, 6 bytes, Stack size 0 bytes, stm32f10x_tim.o(.text), UNUSED)

TIM_SetClockDivision (Thumb, 18 bytes, Stack size 0 bytes, stm32f10x_tim.o(.text), UNUSED)

TIM_GetCapture1 (Thumb, 6 bytes, Stack size 0 bytes, stm32f10x_tim.o(.text), UNUSED)

TIM_GetCapture2 (Thumb, 6 bytes, Stack size 0 bytes, stm32f10x_tim.o(.text), UNUSED)

TIM_GetCapture3 (Thumb, 6 bytes, Stack size 0 bytes, stm32f10x_tim.o(.text), UNUSED)

TIM_GetCapture4 (Thumb, 8 bytes, Stack size 0 bytes, stm32f10x_tim.o(.text), UNUSED)

TIM_GetCounter (Thumb, 6 bytes, Stack size 0 bytes, stm32f10x_tim.o(.text), UNUSED)

TIM_GetPrescaler (Thumb, 6 bytes, Stack size 0 bytes, stm32f10x_tim.o(.text), UNUSED)

TIM_GetFlagStatus (Thumb, 18 bytes, Stack size 0 bytes, stm32f10x_tim.o(.text), UNUSED)

TIM_ClearFlag (Thumb, 6 bytes, Stack size 0 bytes, stm32f10x_tim.o(.text), UNUSED)

TIM_GetITStatus (Thumb, 34 bytes, Stack size 12 bytes, stm32f10x_tim.o(.text), UNUSED)

TIM_ClearITPendingBit (Thumb, 6 bytes, Stack size 0 bytes, stm32f10x_tim.o(.text), UNUSED)

USART_DeInit (Thumb, 134 bytes, Stack size 8 bytes, stm32f10x_usart.o(.text), UNUSED)

[Calls]

- >> RCC_APB1PeriphResetCmd
- >> RCC_APB2PeriphResetCmd

USART_Init (Thumb, 210 bytes, Stack size 56 bytes, stm32f10x_usart.o(.text), UNUSED)

[Calls]

- >> RCC_GetClocksFreq

[Called By]

- >> uart_init

USART_StructInit (Thumb, 24 bytes, Stack size 0 bytes, stm32f10x_usart.o(.text), UNUSED)

USART_ClockInit (Thumb, 34 bytes, Stack size 8 bytes, stm32f10x_usart.o(.text), UNUSED)

USART_ClockStructInit (Thumb, 12 bytes, Stack size 0 bytes, stm32f10x_usart.o(.text), UNUSED)

USART_Cmd (Thumb, 24 bytes, Stack size 0 bytes, stm32f10x_usart.o(.text), UNUSED)

[Called By]

- >> uart_init

USART_ITConfig (Thumb, 74 bytes, Stack size 20 bytes, stm32f10x_usart.o(.text), UNUSED)

[Called By]

- >> uart_init

USART_DMACmd (Thumb, 18 bytes, Stack size 0 bytes, stm32f10x_usart.o(.text), UNUSED)

USART_SetAddress (Thumb, 18 bytes, Stack size 0 bytes, stm32f10x_usart.o(.text), UNUSED)

USART_WakeUpConfig (Thumb, 18 bytes, Stack size 0 bytes, stm32f10x_usart.o(.text), UNUSED)

USART_ReceiverWakeUpCmd (Thumb, 24 bytes, Stack size 0 bytes, stm32f10x_usart.o(.text), UNUSED)

USART_LINBreakDetectLengthConfig (Thumb, 18 bytes, Stack size 0 bytes, stm32f10x_usart.o(.text), UNUSED)

USART_LINCmd (Thumb, 24 bytes, Stack size 0 bytes, stm32f10x_usart.o(.text), UNUSED)

USART_SendData (Thumb, 8 bytes, Stack size 0 bytes, stm32f10x_usart.o(.text), UNUSED)

USART_ReceiveData (Thumb, 10 bytes, Stack size 0 bytes, stm32f10x_usart.o(.text))

[Called By]

- >> USART1_IRQHandler

USART_SendBreak (Thumb, 10 bytes, Stack size 0 bytes, stm32f10x_usart.o(.text), UNUSED)

USART_SetGuardTime (Thumb, 16 bytes, Stack size 0 bytes, stm32f10x_usart.o(.text), UNUSED)

USART_SetPrescaler (Thumb, 16 bytes, Stack size 0 bytes, stm32f10x_usart.o(.text), UNUSED)

USART_SmartCardCmd (Thumb, 24 bytes, Stack size 0 bytes, stm32f10x_usart.o(.text), UNUSED)

USART_SmartCardNACKCmd (Thumb, 24 bytes, Stack size 0 bytes, stm32f10x_usart.o(.text), UNUSED)

USART_HalfDuplexCmd (Thumb, 24 bytes, Stack size 0 bytes, stm32f10x_usart.o(.text), UNUSED)

USART_OverSampling8Cmd (Thumb, 22 bytes, Stack size 0 bytes, stm32f10x_usart.o(.text), UNUSED)

USART_OneBitMethodCmd (Thumb, 24 bytes, Stack size 0 bytes, stm32f10x_usart.o(.text), UNUSED)

USART_IrDAConfig (Thumb, 18 bytes, Stack size 0 bytes, stm32f10x_usart.o(.text), UNUSED)

USART_IrDACmd (Thumb, 24 bytes, Stack size 0 bytes, stm32f10x_usart.o(.text), UNUSED)

USART_GetFlagStatus (Thumb, 26 bytes, Stack size 0 bytes, stm32f10x_usart.o(.text), UNUSED)

USART_ClearFlag (Thumb, 18 bytes, Stack size 0 bytes, stm32f10x_usart.o(.text), UNUSED)

USART_GetITStatus (Thumb, 84 bytes, Stack size 16 bytes, stm32f10x_usart.o(.text))

[Stack]

- Max Depth = 16
- Call Chain = USART_GetITStatus

[Called By]

- >> USART1_IRQHandler

USART_ClearITPendingBit (Thumb, 52 bytes, Stack size 8 bytes, stm32f10x_usart.o(.text), UNUSED)

delay_init (Thumb, 50 bytes, Stack size 8 bytes, delay.o(.text))

[Stack]

- Max Depth = 8
- Call Chain = delay_init

[Calls]

- >> SysTick_CLKSourceConfig

[Called By]

- >> main

delay_us (Thumb, 72 bytes, Stack size 0 bytes, delay.o(.text), UNUSED)

delay_ms (Thumb, 72 bytes, Stack size 0 bytes, delay.o(.text))

[Called By]

- >> Server_180_Angle
- >> Server_360_Forward

_sys_exit (Thumb, 6 bytes, Stack size 0 bytes, usart.o(.text))

[Called By]

- >> __rt_exit_exit

fputc (Thumb, 24 bytes, Stack size 0 bytes, usart.o(.text), UNUSED)

uart_init (Thumb, 152 bytes, Stack size 32 bytes, usart.o(.text), UNUSED)

[Calls]

- >> RCC_APB2PeriphClockCmd
- >> GPIO_Init
- >> NVIC_Init
- >> USART_ITConfig
- >> USART_Cmd
- >> USART_Init

USART1_IRQHandler (Thumb, 122 bytes, Stack size 8 bytes, usart.o(.text))

[Stack]

- Max Depth = 24
- Call Chain = USART1_IRQHandler ⇒ USART_GetITStatus

[Calls]

- >> USART_GetITStatus
- >> USART_ReceiveData

[Address Reference Count : 1]

- startup_stm32f10x_hd.o(RESET)

TIM8_PWM_Init (Thumb, 148 bytes, Stack size 40 bytes, server.o(.text))

[Stack]

- Max Depth = 64
- Call Chain = TIM8_PWM_Init ⇒ GPIO_Init

[Calls]

- >> TIM_OC1Init
- >> TIM_TimeBaseInit
- >> RCC_APB2PeriphClockCmd
- >> GPIO_Init
- >> TIM_OC1PreloadConfig
- >> TIM_CtrlPWMOutputs
- >> TIM_Cmd

[Called By]

- >> main

__use_no_semihosting (Thumb, 2 bytes, Stack size 0 bytes, use_no_semi_2.o(.text), UNUSED)

__use_two_region_memory (Thumb, 2 bytes, Stack size 0 bytes, heapauxi.o(.text), UNUSED)

__rt_heap_escrow$2region (Thumb, 2 bytes, Stack size 0 bytes, heapauxi.o(.text), UNUSED)

__rt_heap_expand$2region (Thumb, 2 bytes, Stack size 0 bytes, heapauxi.o(.text), UNUSED)

__I$use$semihosting (Thumb, 0 bytes, Stack size 0 bytes, use_no_semi.o(.text), UNUSED)

__use_no_semihosting_swi (Thumb, 2 bytes, Stack size 0 bytes, use_no_semi.o(.text), UNUSED)

__user_setup_stackheap (Thumb, 74 bytes, Stack size 8 bytes, sys_stackheap_outer.o(.text))

[Stack]

- Max Depth = 8 + Unknown Stack Size
- Call Chain = __user_setup_stackheap

[Calls]

- >> __user_initial_stackheap
- >> __user_perproc_libspace

[Called By]

- >> __rt_entry_sh

exit (Thumb, 12 bytes, Stack size 0 bytes, exit.o(.text))

[Calls]

- >> __rt_exit

[Called By]

- >> __rt_entry_main

__user_libspace (Thumb, 8 bytes, Stack size 0 bytes, libspace.o(.text), UNUSED)

__user_perproc_libspace (Thumb, 0 bytes, Stack size 0 bytes, libspace.o(.text))

[Called By]

- >> __user_setup_stackheap

__user_perthread_libspace (Thumb, 0 bytes, Stack size 0 bytes, libspace.o(.text), UNUSED)

### Local Symbols

SetSysClockTo72 (Thumb, 214 bytes, Stack size 12 bytes, system_stm32f10x.o(.text))

[Stack]

- Max Depth = 12
- Call Chain = SetSysClockTo72

[Called By]

- >> SetSysClock

SetSysClock (Thumb, 8 bytes, Stack size 8 bytes, system_stm32f10x.o(.text))

[Stack]

- Max Depth = 20
- Call Chain = SetSysClock ⇒ SetSysClockTo72

[Calls]

- >> SetSysClockTo72

[Called By]

- >> SystemInit

TI4_Config (Thumb, 130 bytes, Stack size 20 bytes, stm32f10x_tim.o(.text), UNUSED)

[Called By]

- >> TIM_ICInit

TI3_Config (Thumb, 122 bytes, Stack size 20 bytes, stm32f10x_tim.o(.text), UNUSED)

[Called By]

- >> TIM_ICInit

TI2_Config (Thumb, 130 bytes, Stack size 20 bytes, stm32f10x_tim.o(.text), UNUSED)

[Called By]

- >> TIM_TIxExternalClockConfig
- >> TIM_PWMIConfig
- >> TIM_ICInit

TI1_Config (Thumb, 108 bytes, Stack size 20 bytes, stm32f10x_tim.o(.text), UNUSED)

[Called By]

- >> TIM_TIxExternalClockConfig
- >> TIM_PWMIConfig
- >> TIM_ICInit

### Undefined Global Symbols
