qqqqLH/STM32_smart_door/SCH.pdf

电源指示灯 | 蜂鸣器 LDO3.3

# USB

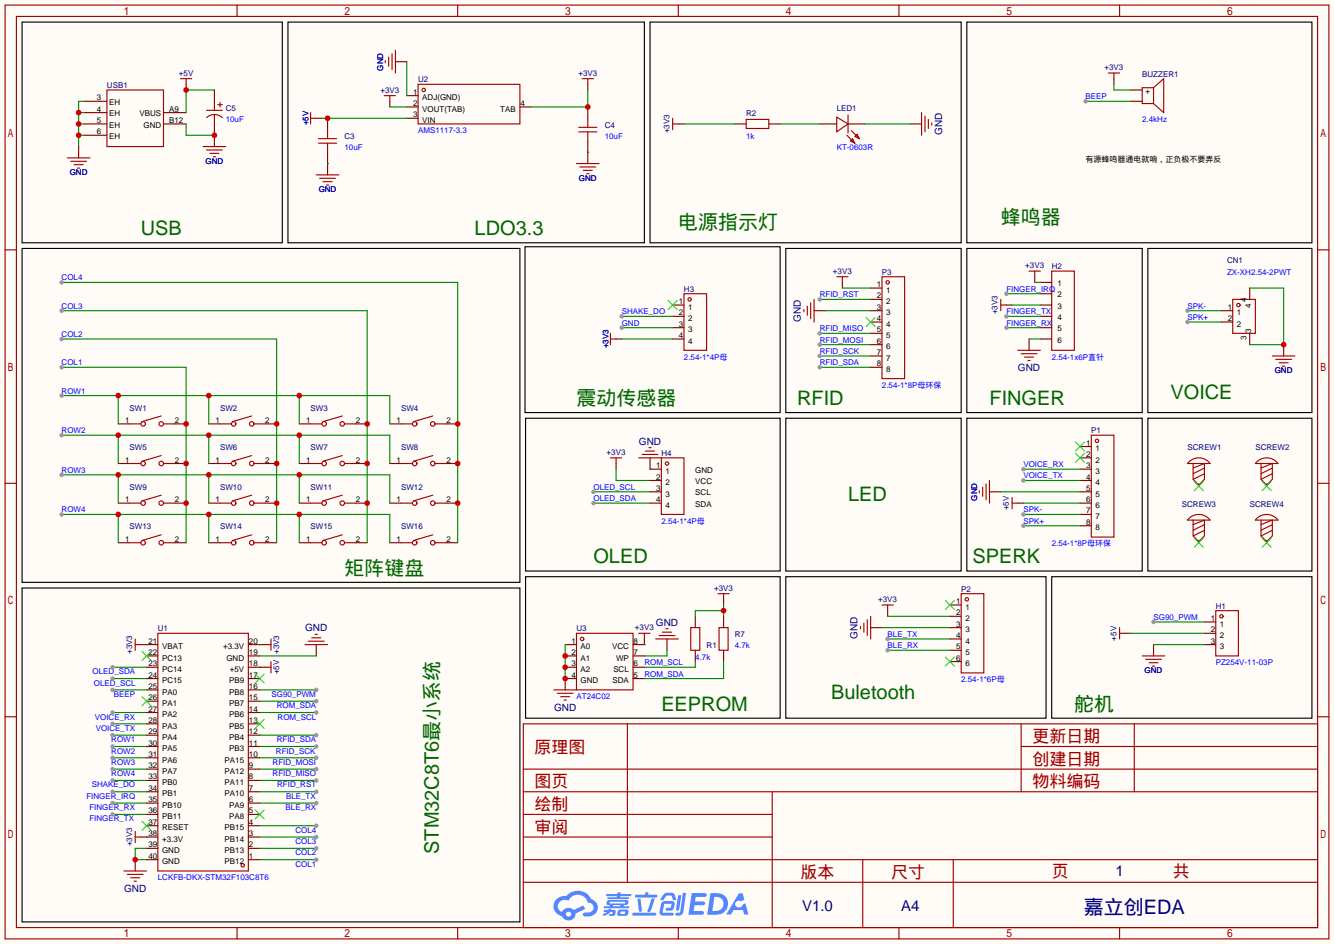
[picture p2: page 1]
