qqqqLH/STM32_smart_door/Core/Inc/main.h

#define OLED_SDA_Pin GPIO_PIN_14
#define OLED_SDA_GPIO_Port GPIOC
#define OLED_SCL_Pin GPIO_PIN_15
#define OLED_SCL_GPIO_Port GPIOC
#define BEEP_Pin GPIO_PIN_0
#define BEEP_GPIO_Port GPIOA
#define ROW1_Pin GPIO_PIN_4
#define ROW1_GPIO_Port GPIOA
#define ROW2_Pin GPIO_PIN_5
#define ROW2_GPIO_Port GPIOA
#define ROW3_Pin GPIO_PIN_6
#define ROW3_GPIO_Port GPIOA
#define ROW4_Pin GPIO_PIN_7
#define ROW4_GPIO_Port GPIOA
#define SHAKE_DO_Pin GPIO_PIN_0
#define SHAKE_DO_GPIO_Port GPIOB
#define FINGER_IRQ_Pin GPIO_PIN_1
#define FINGER_IRQ_GPIO_Port GPIOB
#define FINGER_IRQ_EXTI_IRQn EXTI1_IRQn
#define COL1_Pin GPIO_PIN_12
#define COL1_GPIO_Port GPIOB
#define COL2_Pin GPIO_PIN_13
#define COL2_GPIO_Port GPIOB
#define COL3_Pin GPIO_PIN_14
#define COL3_GPIO_Port GPIOB
#define COL4_Pin GPIO_PIN_15
#define COL4_GPIO_Port GPIOB
#define RFID_RST_Pin GPIO_PIN_11
#define RFID_RST_GPIO_Port GPIOA
#define RFID_MISO_Pin GPIO_PIN_12
#define RFID_MISO_GPIO_Port GPIOA
#define RFID_MOSI_Pin GPIO_PIN_15
#define RFID_MOSI_GPIO_Port GPIOA
#define RFID_SCK_Pin GPIO_PIN_3
#define RFID_SCK_GPIO_Port GPIOB
#define RFID_SDA_Pin GPIO_PIN_4
#define RFID_SDA_GPIO_Port GPIOB
