qqqqLH/STM32_smart_door/BSP/OLED/oled.h

#ifndef __OLED_H
#define __OLED_H

#include "main.h"

#define u8 uint8_t
#define u32 uint32_t

#define OLED_CMD 0u
#define OLED_DATA 1u

#define OLED_SCL_PORT GPIOC
#define OLED_SCL_PIN GPIO_PIN_15

#define OLED_SDA_PORT GPIOC
#define OLED_SDA_PIN GPIO_PIN_14

#define OLED_SCLK_Set() HAL_GPIO_WritePin(OLED_SCL_PORT, OLED_SCL_PIN, GPIO_PIN_SET)
#define OLED_SCLK_Clr() HAL_GPIO_WritePin(OLED_SCL_PORT, OLED_SCL_PIN, GPIO_PIN_RESET)

#define OLED_SDIN_Set() HAL_GPIO_WritePin(OLED_SDA_PORT, OLED_SDA_PIN, GPIO_PIN_SET)
#define OLED_SDIN_Clr() HAL_GPIO_WritePin(OLED_SDA_PORT, OLED_SDA_PIN, GPIO_PIN_RESET)

#define SIZE 16
#define XLevelL 0x02
#define XLevelH 0x10
#define Max_Column 128
#define Max_Row 64
#define Brightness 0xFF
#define X_WIDTH 128
#define Y_WIDTH 64

typedef struct
{
  volatile uint32_t blocks_sent;
  volatile uint32_t data_bytes;
  volatile uint32_t dma_errors;
} OLED_Diagnostics;
extern OLED_Diagnostics g_oled_diag;

/* OLED_Task owns the bus. Once ready, wrap framebuffer drawing in Begin/End.
 * Low-level command/IIC functions are for panel startup only. */
void OLED_Task(void *argument);
uint8_t OLED_IsReady(void);
void OLED_BeginFrame(void);
void OLED_EndFrame(void);
void OLED_DMA_IRQHandler(void);

void delay_ms(unsigned int ms);
void OLED_GPIO_Init(void);

void OLED_WR_Byte(unsigned dat, unsigned cmd);
void OLED_Display_On(void);
void OLED_Display_Off(void);
void OLED_Init(void);
void OLED_Clear(void);
void OLED_DrawPoint(u8 x, u8 y, u8 t);
void OLED_Fill(u8 x1, u8 y1, u8 x2, u8 y2, u8 dot);
void OLED_ShowChar(u8 x, u8 y, u8 chr, u8 Char_Size);
void OLED_ShowNum(u8 x, u8 y, u32 num, u8 len, u8 size);
void OLED_ShowString(u8 x, u8 y, u8 *p, u8 Char_Size);
void OLED_Set_Pos(unsigned char x, unsigned char y);
void OLED_ShowCHinese(u8 x, u8 y, u8 no);
void OLED_DrawBMP(unsigned char x0, unsigned char y0, unsigned char x1, unsigned char y1, unsigned char BMP[]);
void Delay_50ms(unsigned int Del_50ms);
void Delay_1ms(unsigned int Del_1ms);
void fill_picture(unsigned char fill_Data);
void Picture(void);
void IIC_Start(void);
void IIC_Stop(void);
void Write_IIC_Command(unsigned char IIC_Command);
void Write_IIC_Data(unsigned char IIC_Data);
void Write_IIC_Byte(unsigned char IIC_Byte);
void IIC_Wait_Ack(void);

#endif
