qqqqLH/STM32_smart_door/BSP/KEY/KEY.c

#include "KEY.h"

void KEY_Init(void)
{
  HAL_GPIO_WritePin(ROW1_GPIO_Port, ROW1_Pin, GPIO_PIN_SET);
  HAL_GPIO_WritePin(ROW2_GPIO_Port, ROW2_Pin, GPIO_PIN_SET);
  HAL_GPIO_WritePin(ROW3_GPIO_Port, ROW3_Pin, GPIO_PIN_SET);
  HAL_GPIO_WritePin(ROW4_GPIO_Port, ROW4_Pin, GPIO_PIN_SET);
}

uint16_t KEY_ScanMatrix(void)
{
  uint16_t mask = 0;

  HAL_GPIO_WritePin(ROW1_GPIO_Port, ROW1_Pin, GPIO_PIN_RESET);
  if (HAL_GPIO_ReadPin(COL1_GPIO_Port, COL1_Pin) == GPIO_PIN_RESET) mask |= (1U << 0);
  if (HAL_GPIO_ReadPin(COL2_GPIO_Port, COL2_Pin) == GPIO_PIN_RESET) mask |= (1U << 1);
  if (HAL_GPIO_ReadPin(COL3_GPIO_Port, COL3_Pin) == GPIO_PIN_RESET) mask |= (1U << 2);
  if (HAL_GPIO_ReadPin(COL4_GPIO_Port, COL4_Pin) == GPIO_PIN_RESET) mask |= (1U << 3);
  HAL_GPIO_WritePin(ROW1_GPIO_Port, ROW1_Pin, GPIO_PIN_SET);

  HAL_GPIO_WritePin(ROW2_GPIO_Port, ROW2_Pin, GPIO_PIN_RESET);
  if (HAL_GPIO_ReadPin(COL1_GPIO_Port, COL1_Pin) == GPIO_PIN_RESET) mask |= (1U << 4);
  if (HAL_GPIO_ReadPin(COL2_GPIO_Port, COL2_Pin) == GPIO_PIN_RESET) mask |= (1U << 5);
  if (HAL_GPIO_ReadPin(COL3_GPIO_Port, COL3_Pin) == GPIO_PIN_RESET) mask |= (1U << 6);
  if (HAL_GPIO_ReadPin(COL4_GPIO_Port, COL4_Pin) == GPIO_PIN_RESET) mask |= (1U << 7);
  HAL_GPIO_WritePin(ROW2_GPIO_Port, ROW2_Pin, GPIO_PIN_SET);

  HAL_GPIO_WritePin(ROW3_GPIO_Port, ROW3_Pin, GPIO_PIN_RESET);
  if (HAL_GPIO_ReadPin(COL1_GPIO_Port, COL1_Pin) == GPIO_PIN_RESET) mask |= (1U << 8);
  if (HAL_GPIO_ReadPin(COL2_GPIO_Port, COL2_Pin) == GPIO_PIN_RESET) mask |= (1U << 9);
  if (HAL_GPIO_ReadPin(COL3_GPIO_Port, COL3_Pin) == GPIO_PIN_RESET) mask |= (1U << 10);
  if (HAL_GPIO_ReadPin(COL4_GPIO_Port, COL4_Pin) == GPIO_PIN_RESET) mask |= (1U << 11);
  HAL_GPIO_WritePin(ROW3_GPIO_Port, ROW3_Pin, GPIO_PIN_SET);

  HAL_GPIO_WritePin(ROW4_GPIO_Port, ROW4_Pin, GPIO_PIN_RESET);
  if (HAL_GPIO_ReadPin(COL1_GPIO_Port, COL1_Pin) == GPIO_PIN_RESET) mask |= (1U << 12);
  if (HAL_GPIO_ReadPin(COL2_GPIO_Port, COL2_Pin) == GPIO_PIN_RESET) mask |= (1U << 13);
  if (HAL_GPIO_ReadPin(COL3_GPIO_Port, COL3_Pin) == GPIO_PIN_RESET) mask |= (1U << 14);
  if (HAL_GPIO_ReadPin(COL4_GPIO_Port, COL4_Pin) == GPIO_PIN_RESET) mask |= (1U << 15);
  HAL_GPIO_WritePin(ROW4_GPIO_Port, ROW4_Pin, GPIO_PIN_SET);

  return mask;
}

uint8_t KEY_Scan(void)
{
  uint16_t mask = KEY_ScanMatrix();
  uint8_t i;

  if (mask == 0)
  {
    return 0;
  }

  for (i = 0; i < 16; i++)
  {
    if (mask & (1U << i))
    {
      return (uint8_t)(i + 1U);
    }
  }

  return 0;
}
