qqqqLH/STM32_smart_door/(notices)

Notices in the files:
BSP/SERVO/舵机控制例程/舵机控制例程/舵机例程/360度舵机 Arduino 例程/Servo_0_360/Servo_0_360.ino:
under the terms of the GNU General Public License as published by the
Free Software Foundation, in version 3.
Core/Inc/main.h:
© Copyright (c) 2026 STMicroelectronics.
All rights reserved.
This software component is licensed by ST under BSD 3-Clause license,
the "License"; You may not use this file except in compliance with the
License. You may obtain a copy of the License at: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
Core/Src/usart.c:
Copyright (c) 2026 STMicroelectronics.
This software is licensed under terms that can be found in the LICENSE file
